marcorispoli/PCB305/(list of files, cad)

Other CAD files:
ESECUTIVI/PF22-305-0.dwg
LAYOUT/22-305-0.dwg
