marcorispoli/PCB305/ORCAD/SE22-305-0.pdf

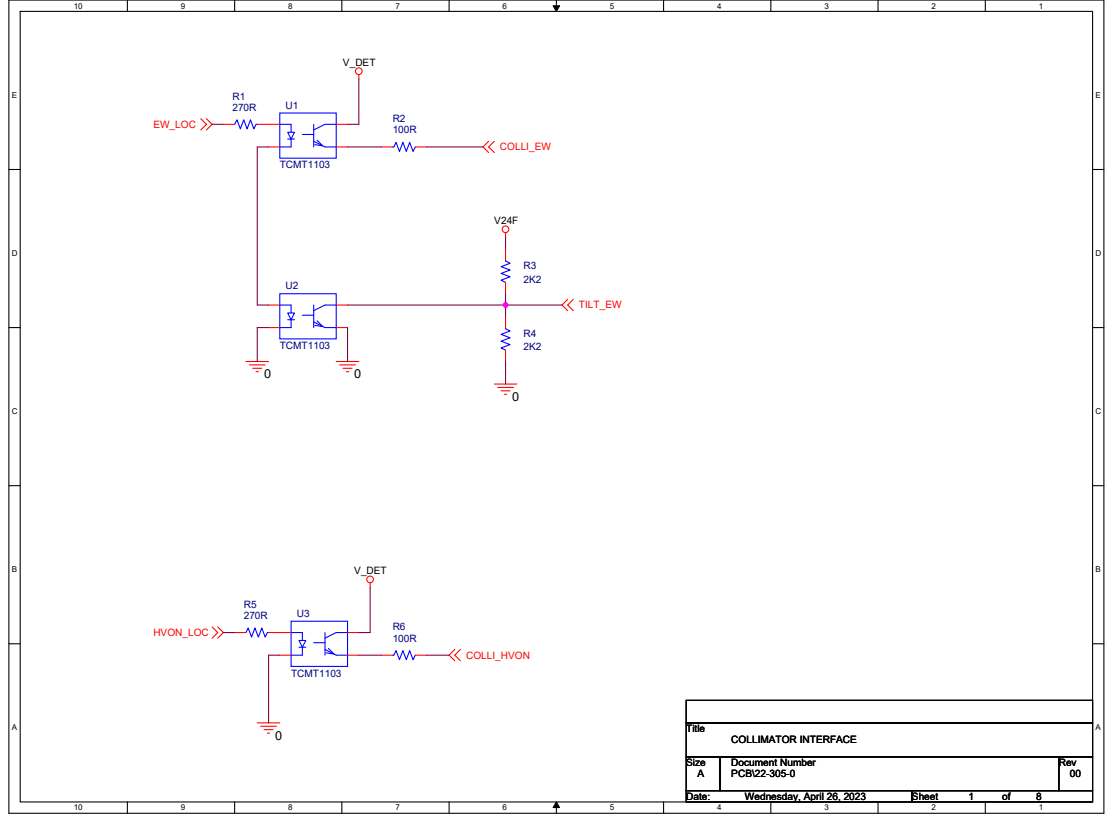
[picture p1: page 1]

Size A A A | Document Number PCB\22-305-0 | Rev 00

Date: Wednesday, April 26, 2023 Wednesday, April 26, 2023 Wednesday, April 26, 2023 | Sheet 1 1 1 of 8 8 8

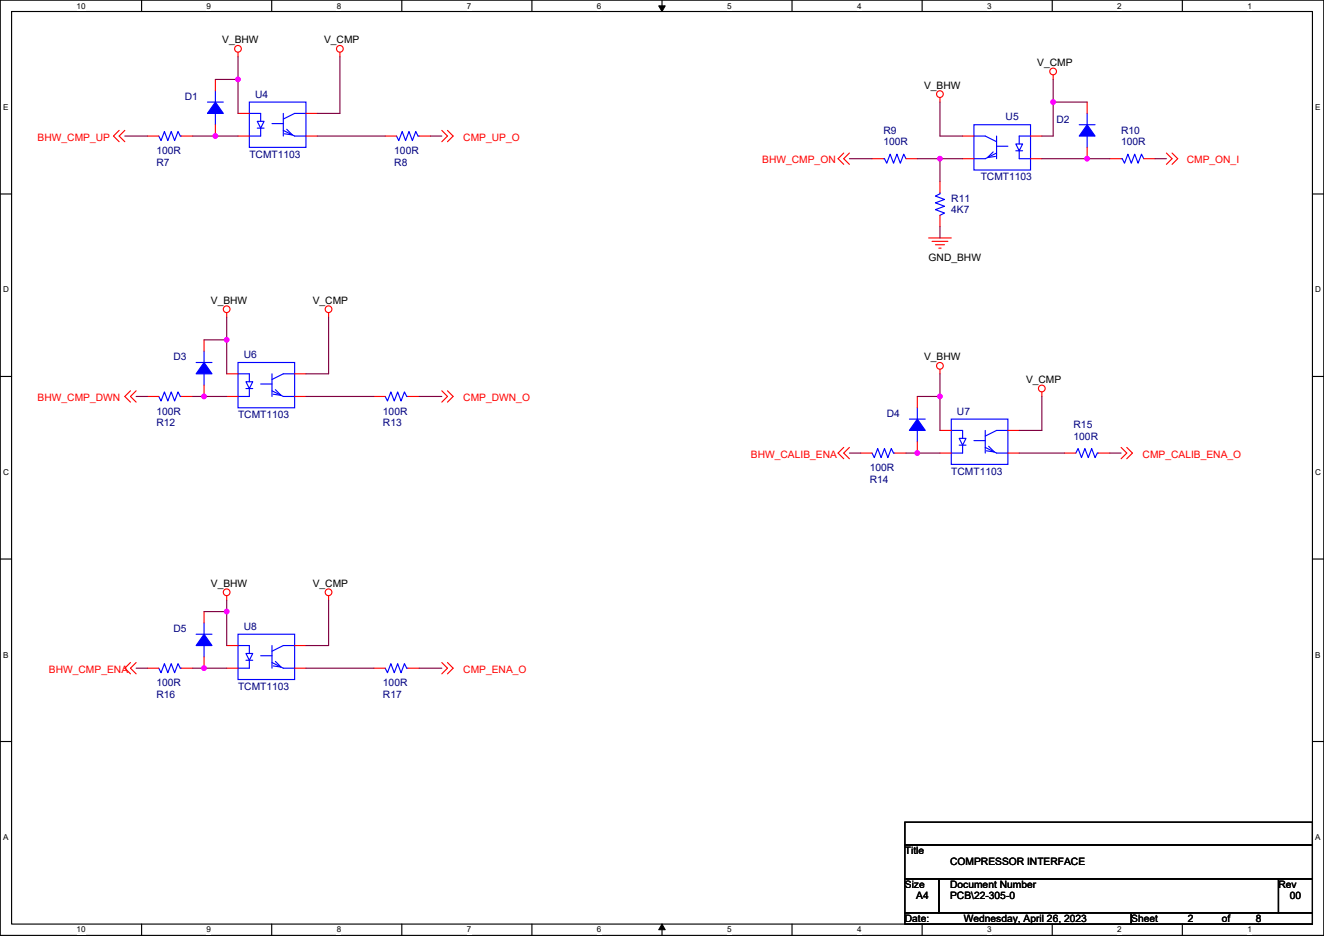
[picture p2: page 2]

Wednesday, April 26, 2023 Wednesday, April 26, 2023 Wednesday, April 26, 2023 | 2 2 2 8 8 8

## POWER-IN

## BUS HARDWARE INPUT

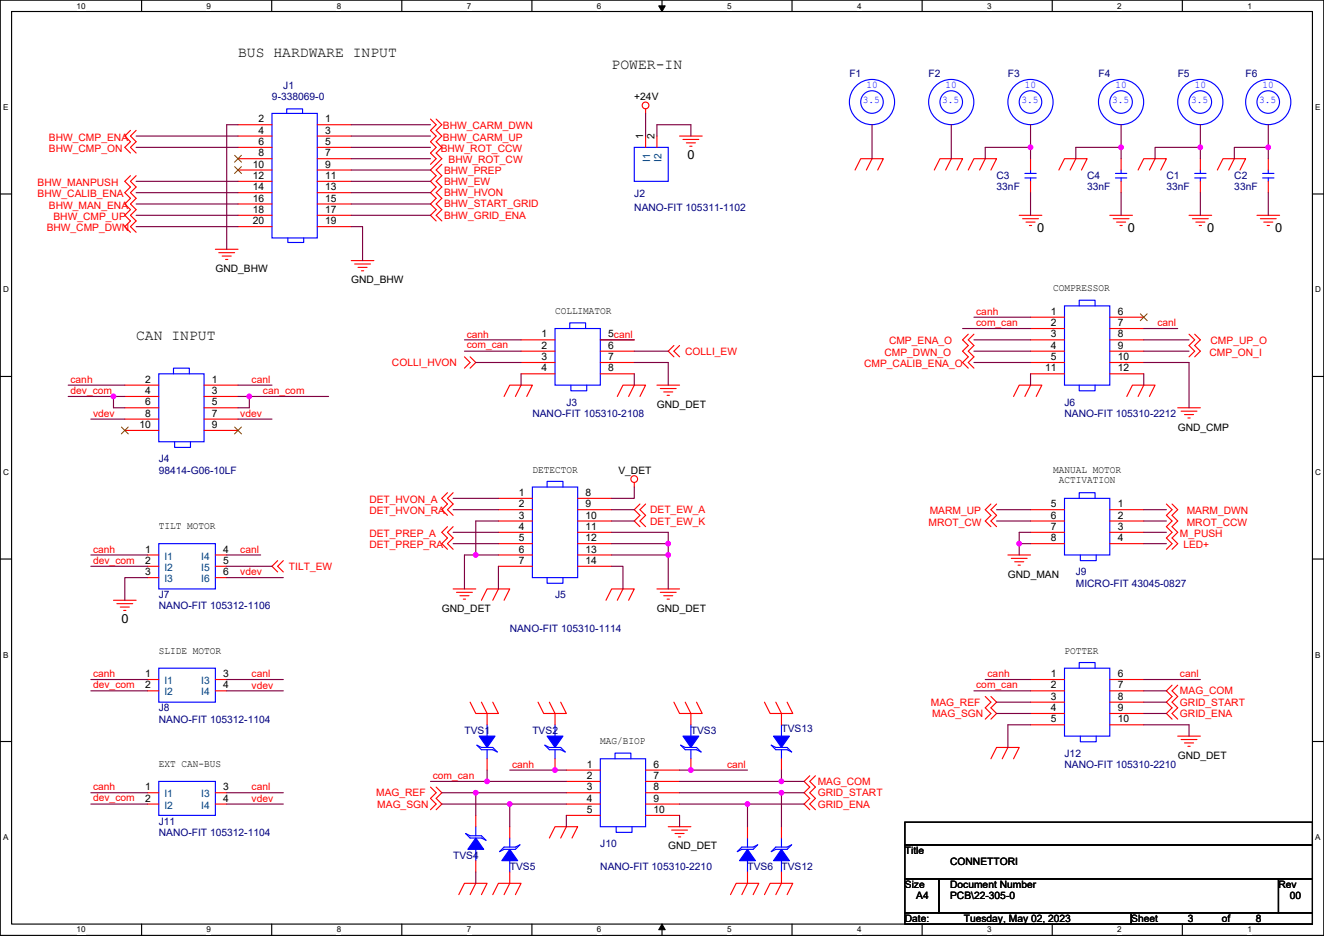
[picture p3: page 3]

0

0

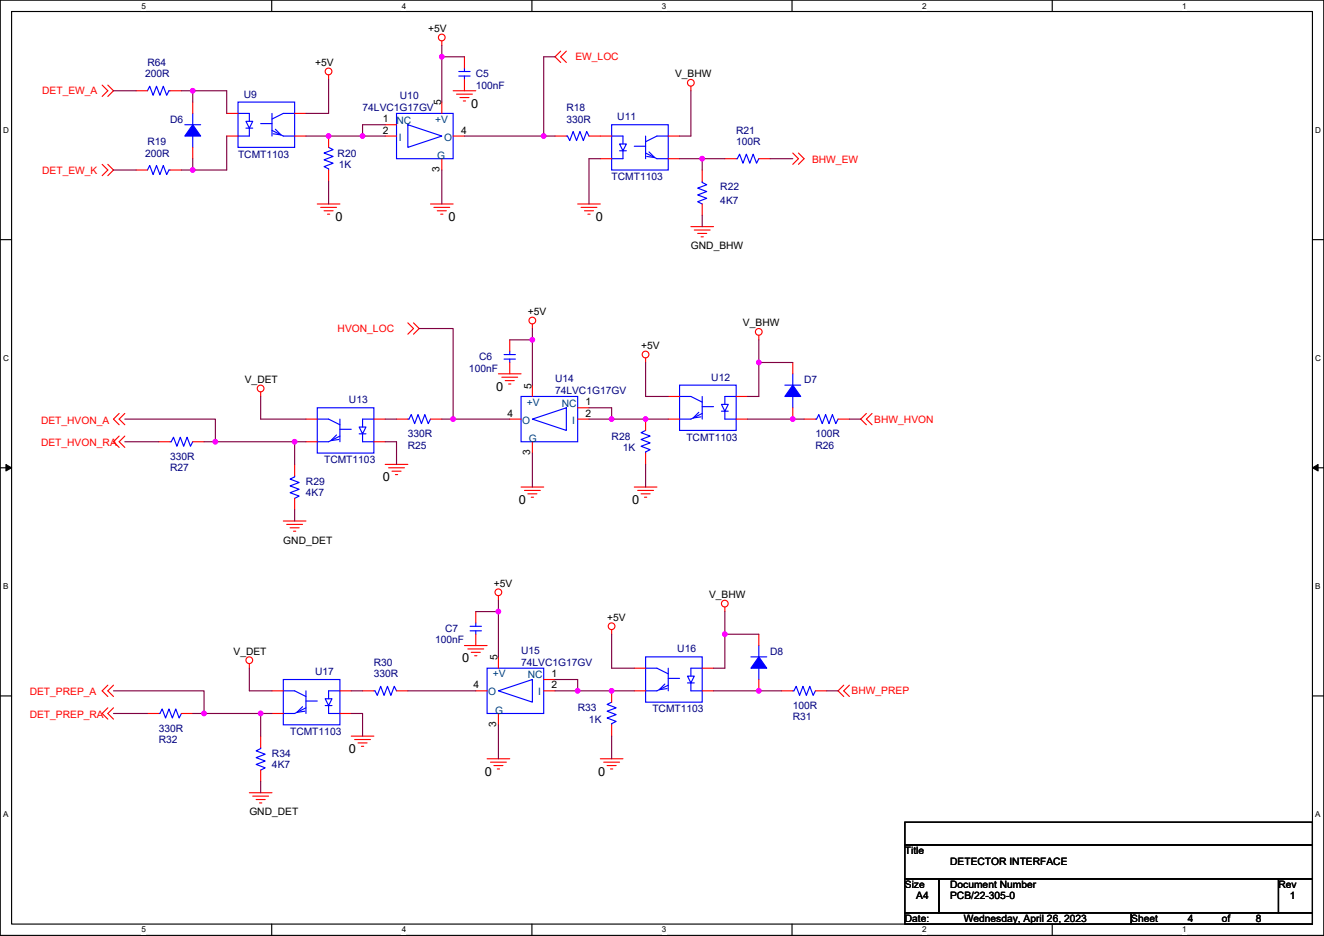
[picture p4: page 4]

PCB/22-305-0 PCB/22-305-0 PCB/22-305-0 | 1 1 1

Wednesday, April 26, 2023 Wednesday, April 26, 2023 Wednesday, April 26, 2023 | 4 4 4 8 8 8

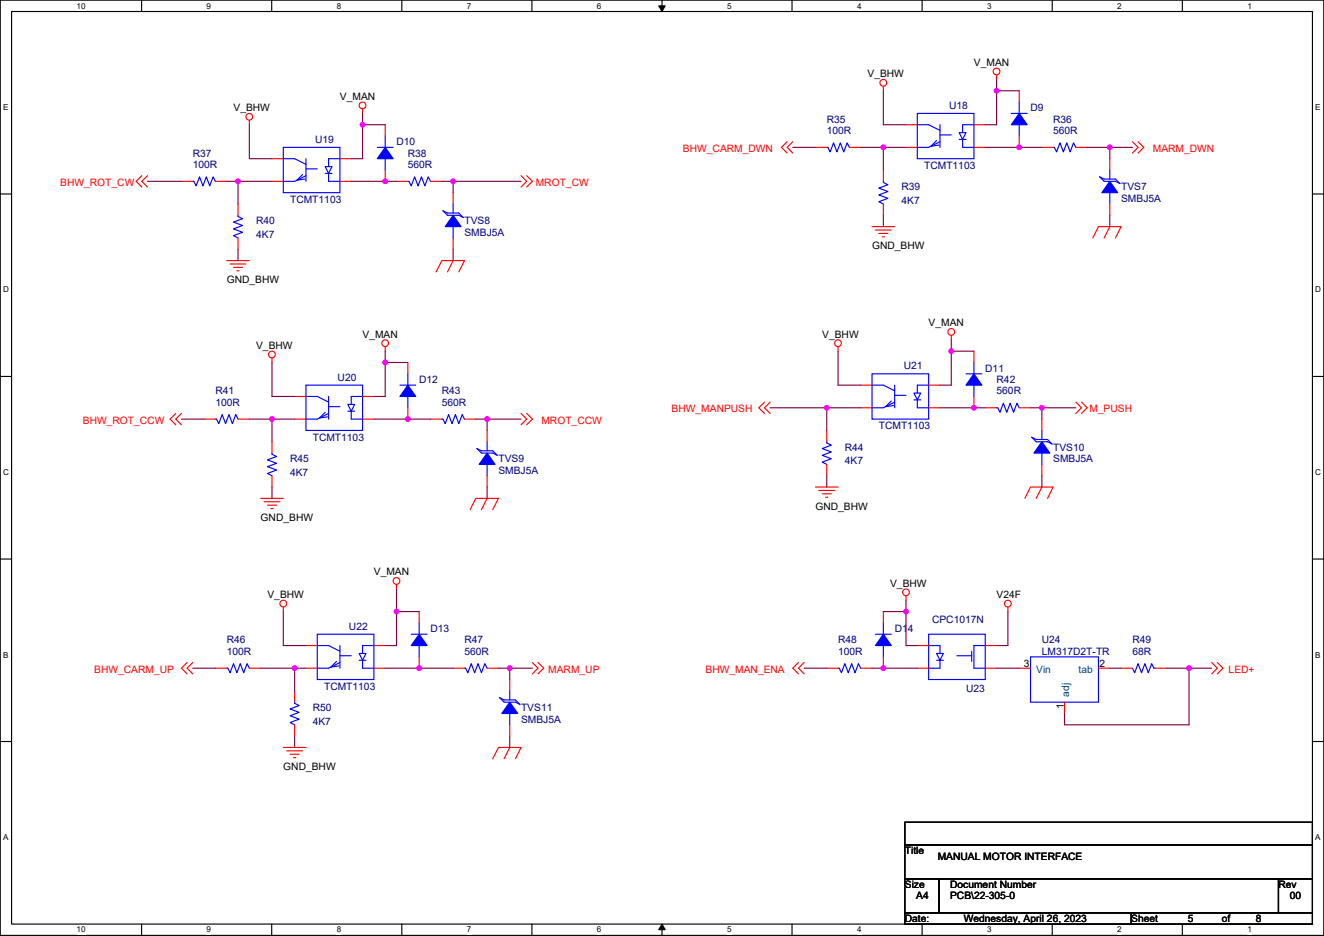
[picture p5: page 5]

0

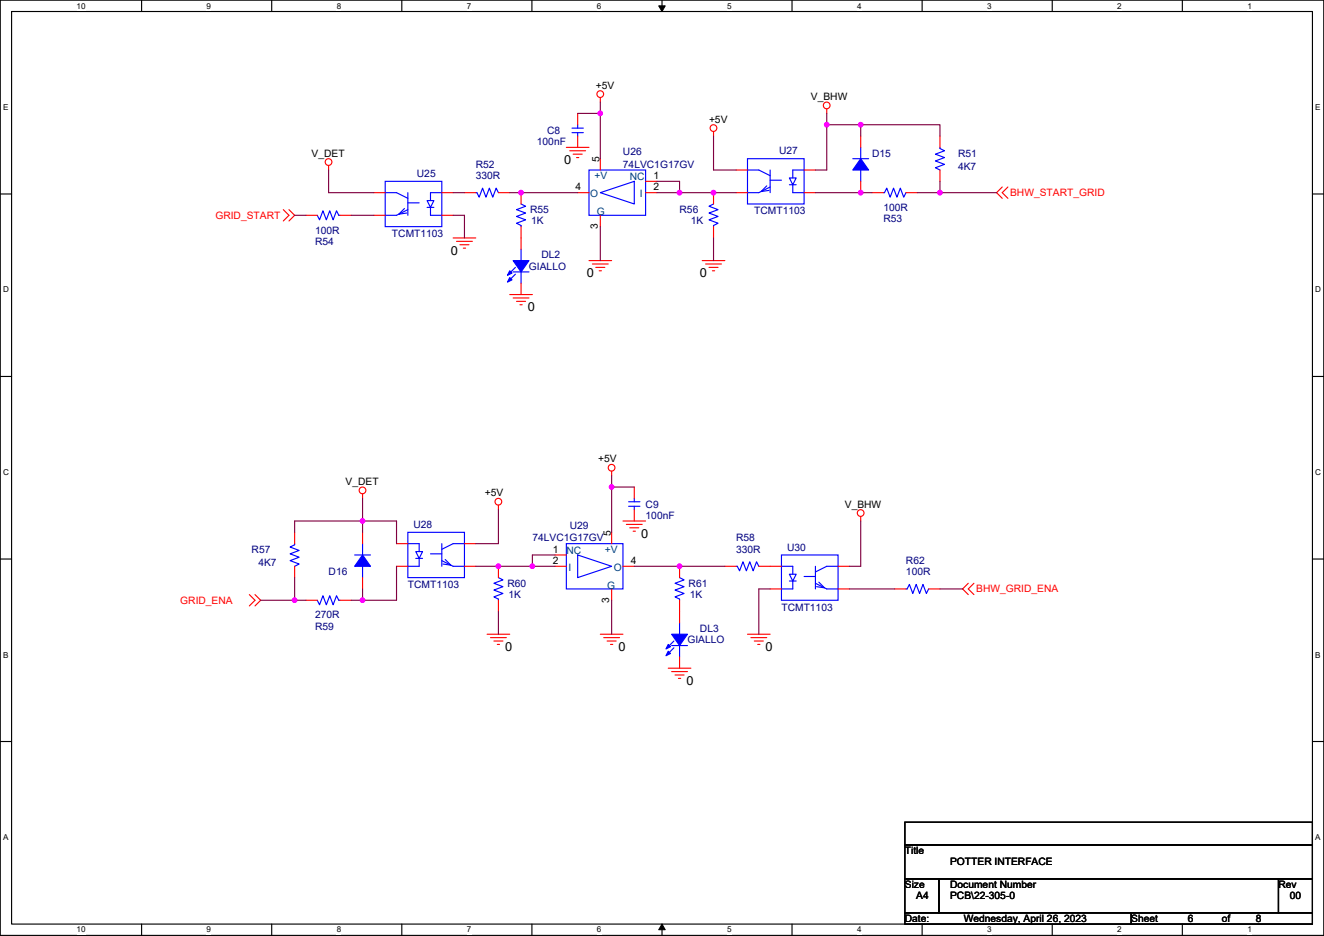
[picture p6: page 6]

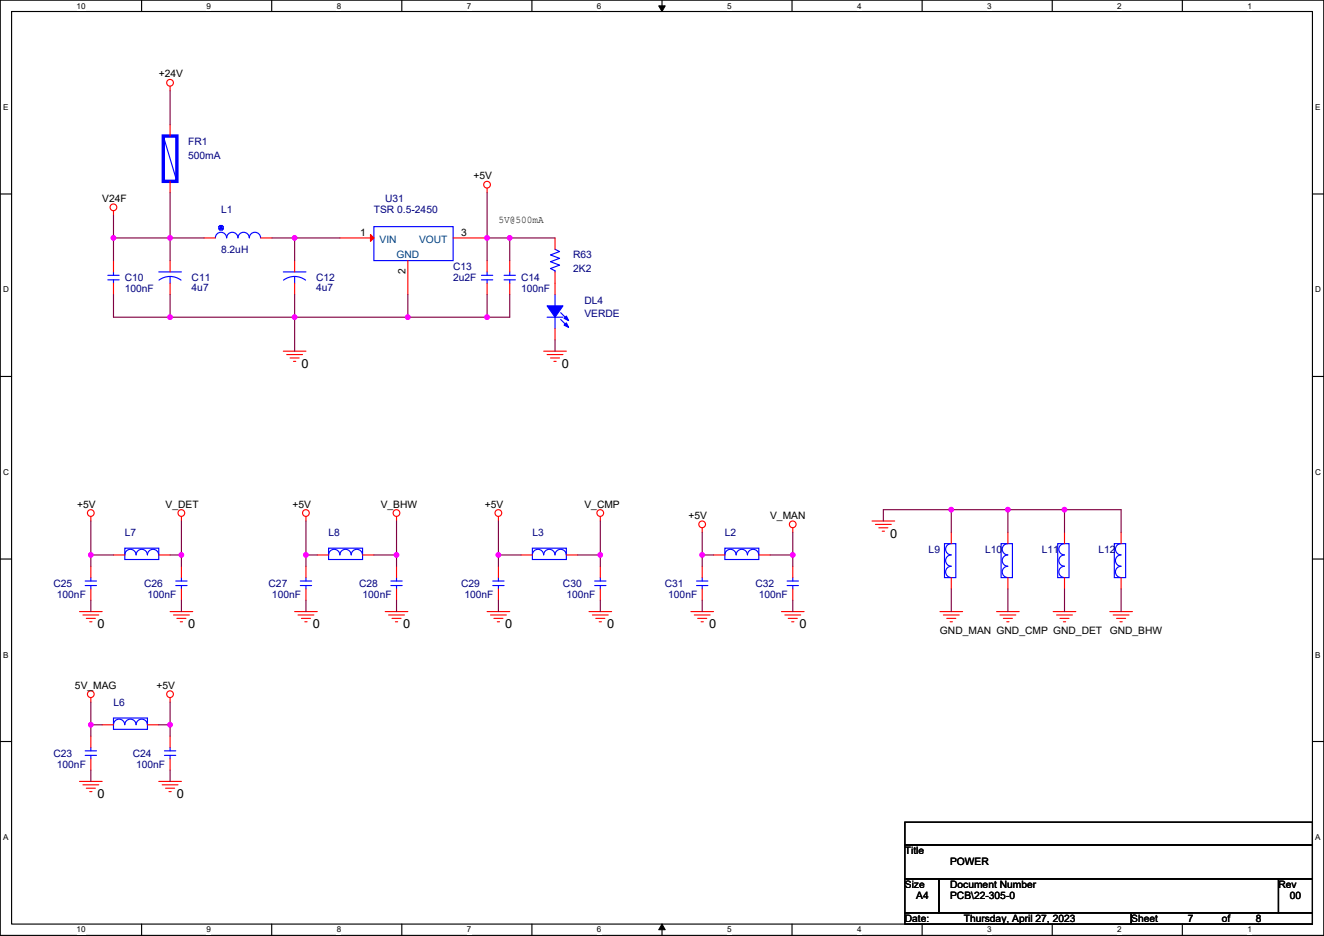
[picture p7: page 7]
