marcorispoli/PCB305/ESECUTIVI/PF22-305-0.pdf

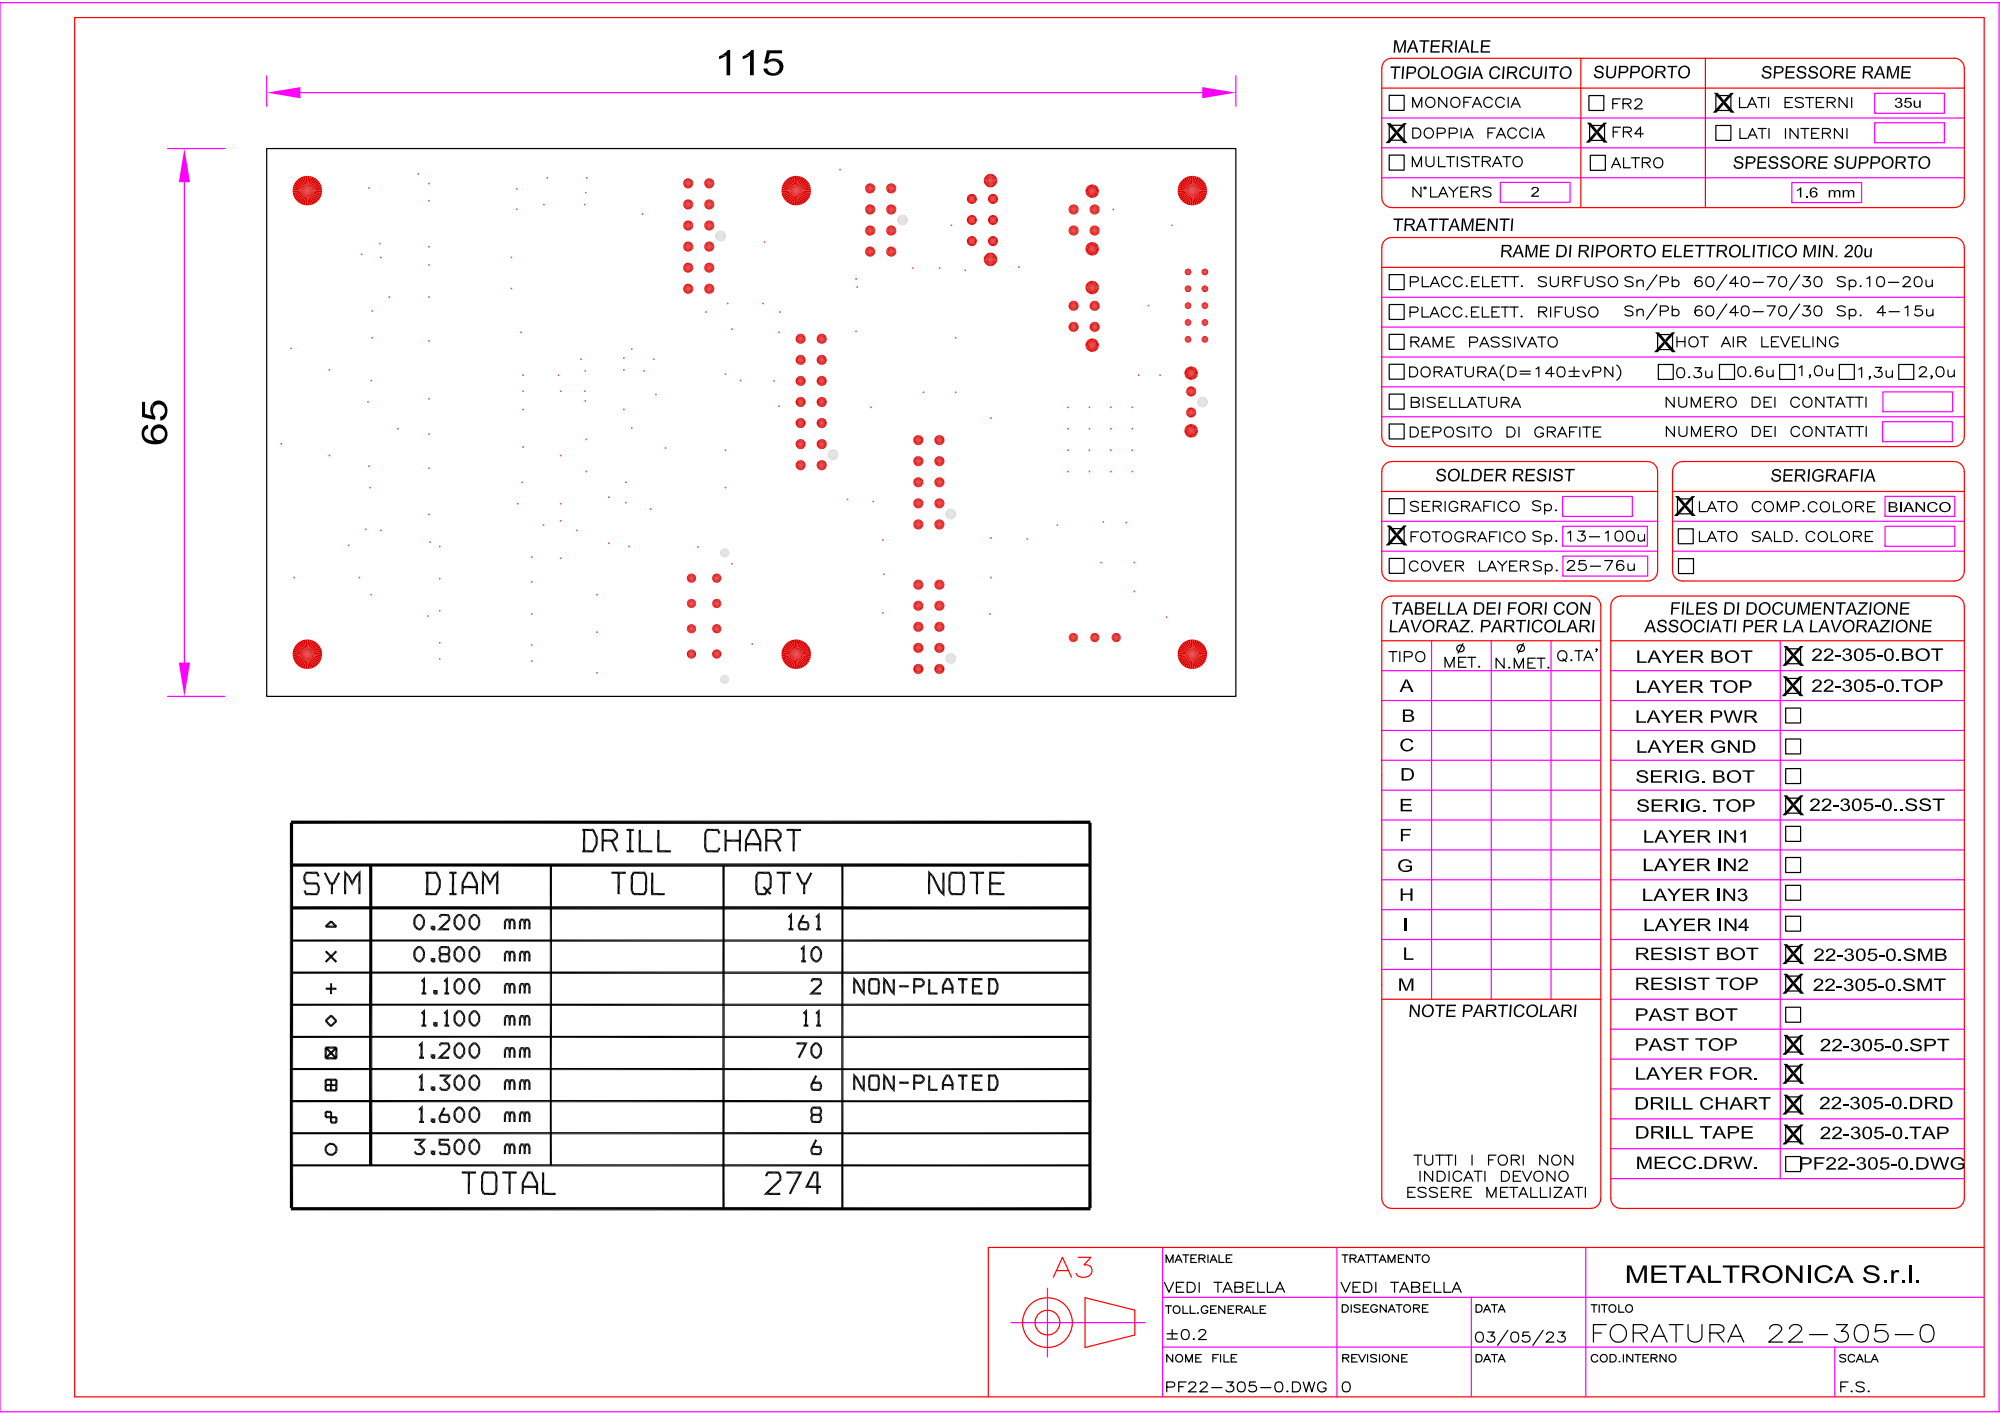
[picture p8: page 1]
