marcorispoli/PCB305/ESECUTIVI/PM22-305-0.pdf

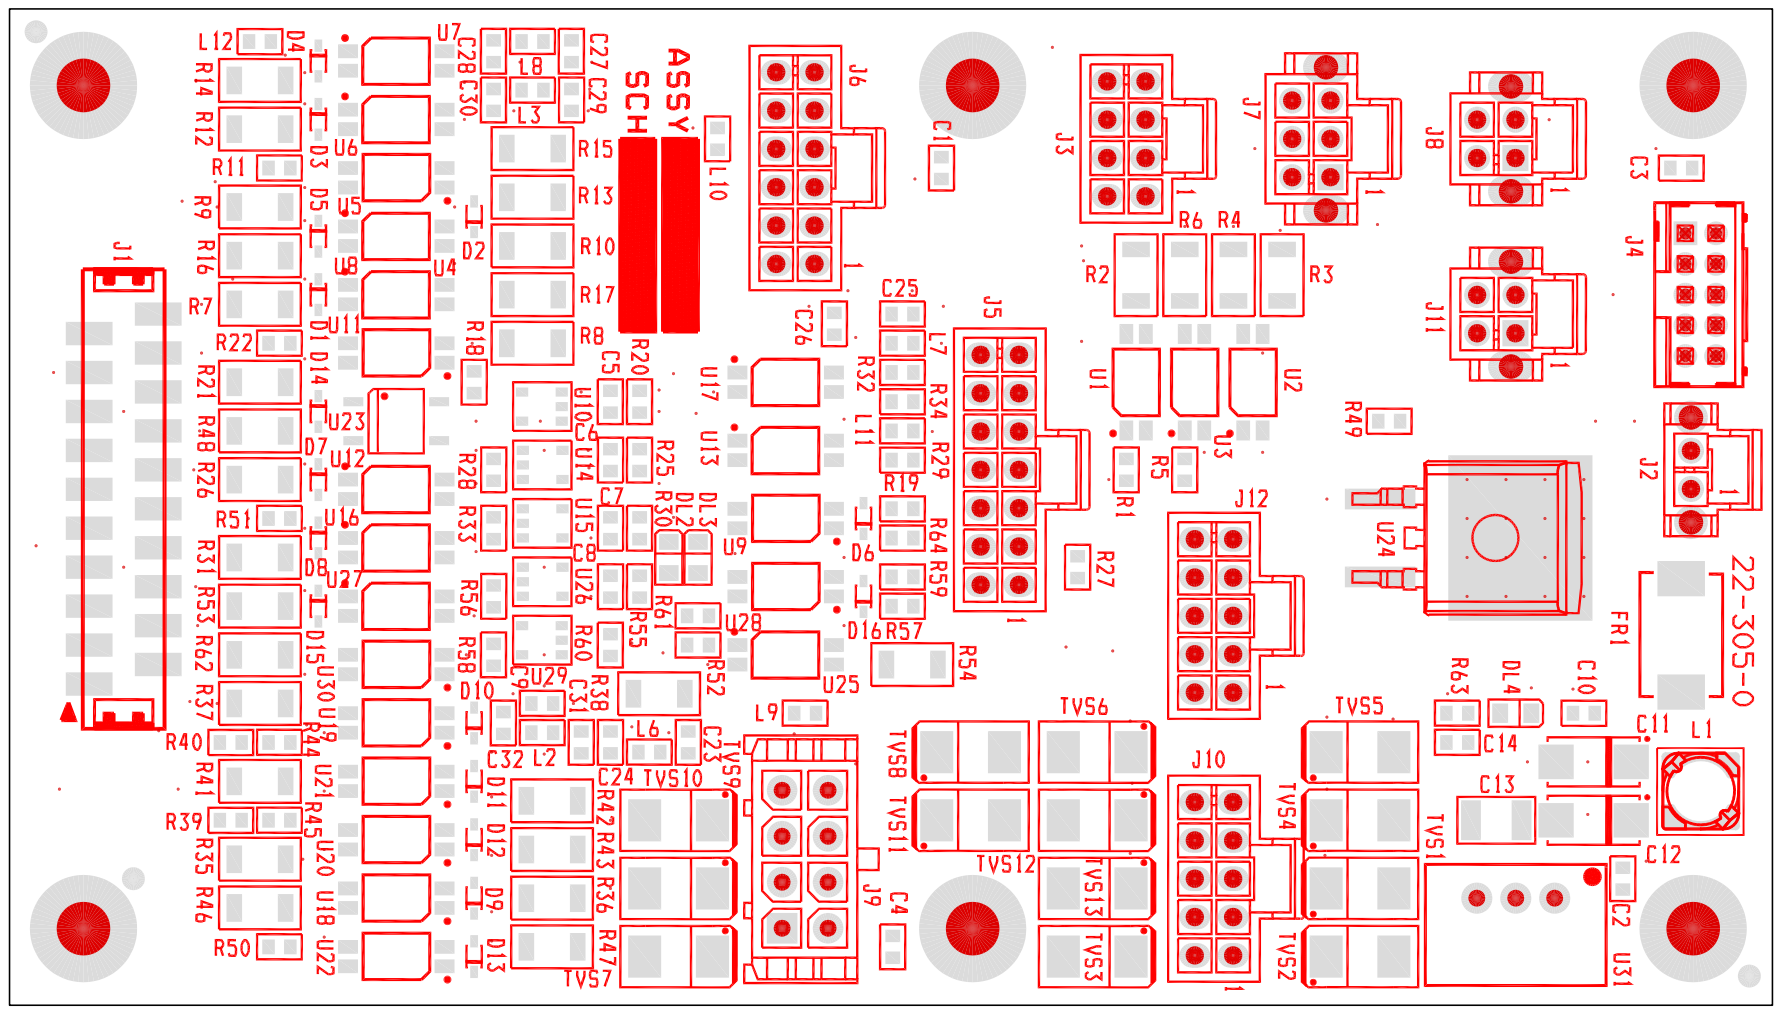
[picture p9: page 1]
