marcorispoli/PCB305/(list of files, drawings)

Other design files:
ORCAD/22-305-0.DSN
ORCAD/22-305-0.opj
