marcorispoli/PCB305/(commit log)

2022-09-23 Iniziato sviluppo interfaccia attivazione motori manuale
    [22-305-0.DSN, 22-305-0.opj]
2022-09-29 Completato il disegno di massima
    [22-305-0.DSN, 22-305-0.opj]
2022-10-12 Corretta la numerazione dei pin di alcuni connettori
    Nella pagina CONNETTORI modificati i connettori
    - NANO-FIT : J5, J6, J7, J8, J9, J10, J11
    - MICRO-FIT : J12
    [22-305-0.DSN]
2023-04-11 Circuito inviato a Osvaldo
    [22-305-0.DSN, 22-305-0.opj]
2023-04-20 Modificato schematico e piazzamento per osvaldo
    [22-305-0.DSN, 22-305-0.opj, PCB305.dxf, PCB305.pcb]
2023-05-04 RELEASE 1.0
    [22-305-0.DSN, 22-305-0.dwg, 22-305-0.opj, LP22-305-0.xlsx, PCB305.dxf, PCB305.pcb, PF22-305-0.dwg]
2024-02-05 Modificato circuito per azionamento manuale motori: il regolatore fornisce un massimo di 80mA al carico
    [22-305-0.DSN, 22-305-0.opj]
2024-03-11 - Sostituito connettore J10 per Protezione paziente con connettore per Biopsia - Eliminato ESDA su connettore ora di biopsia
    [22-305-0.DSN, 22-305-0.opj]
2024-07-15 Aggiunto modifiche ai connettori
    [22-305-0.DSN, 22-305-0.opj]
